Sansh2356/Mice-or-mouse/images/asus_wireless.jpeg

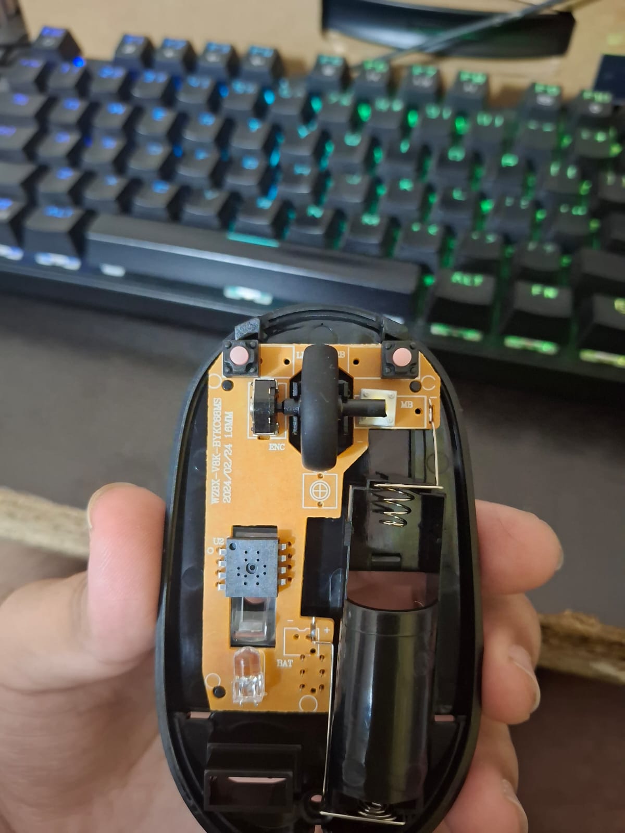
images/asus_wireless.jpeg
