Sansh2356/Mice-or-mouse/images/backview_A603EP.jpeg

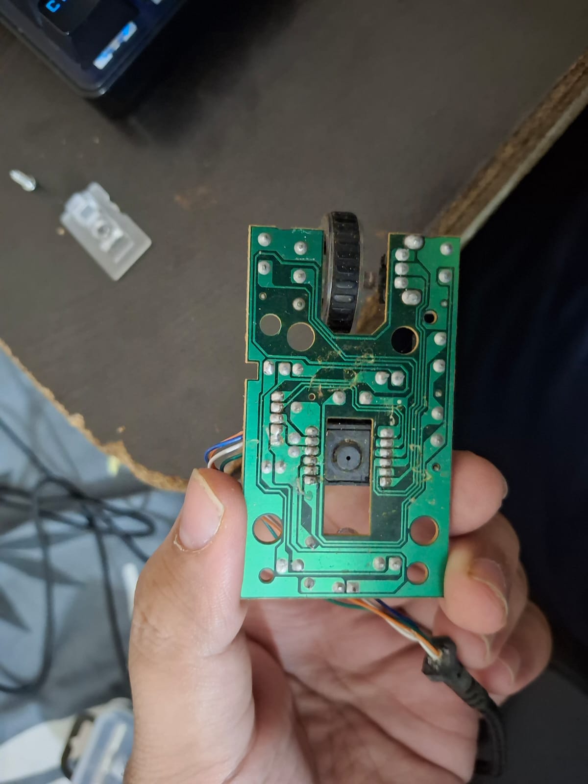
images/backview_A603EP.jpeg
