Sansh2356/Mice-or-mouse/images/closeup_view_front_A603EP.jpeg

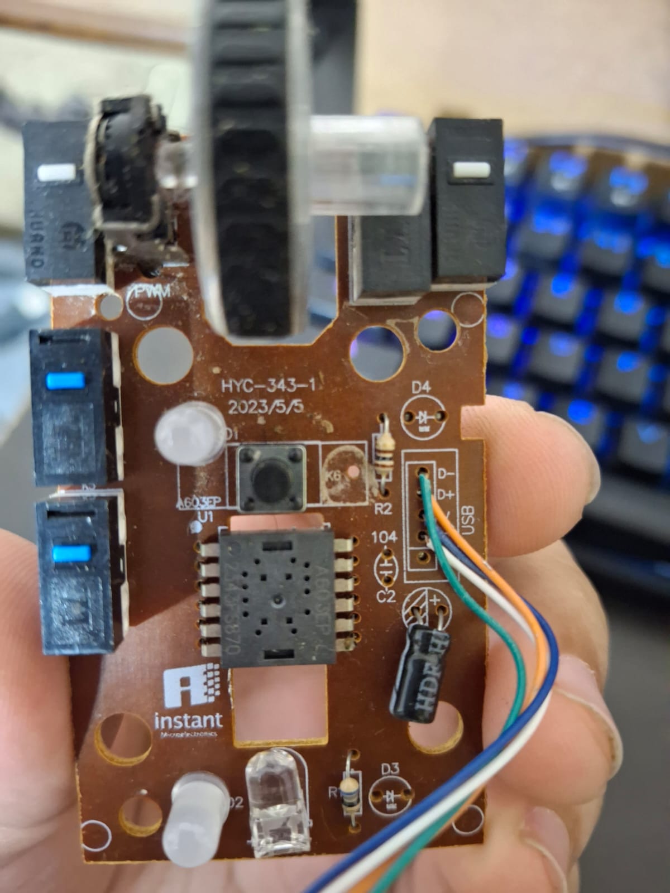
images/closeup_view_front_A603EP.jpeg
