Sansh2356/Mice-or-mouse/images/front_view_A603EP.jpeg

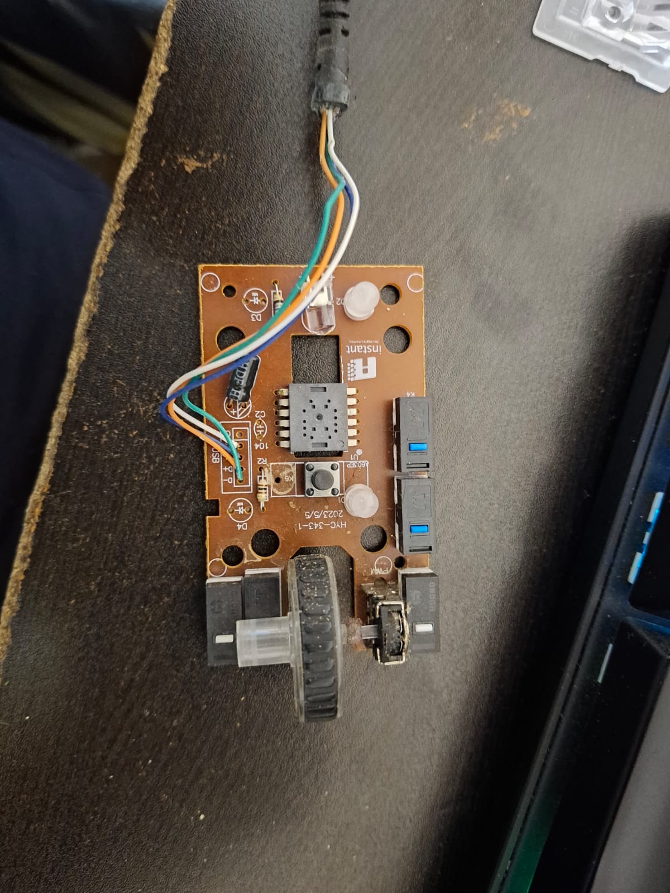
images/front_view_A603EP.jpeg
