Sansh2356/Mice-or-mouse/images/Inner_body_frame.jpeg

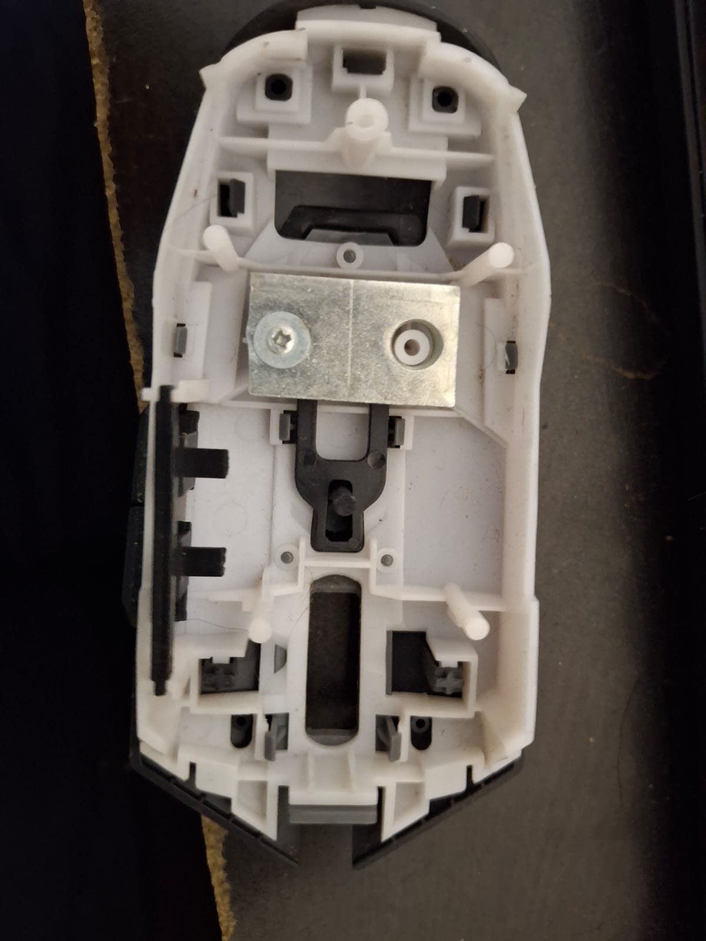
images/Inner_body_frame.jpeg
