Sansh2356/Mice-or-mouse/images/optical_lens_A603EP.jpeg

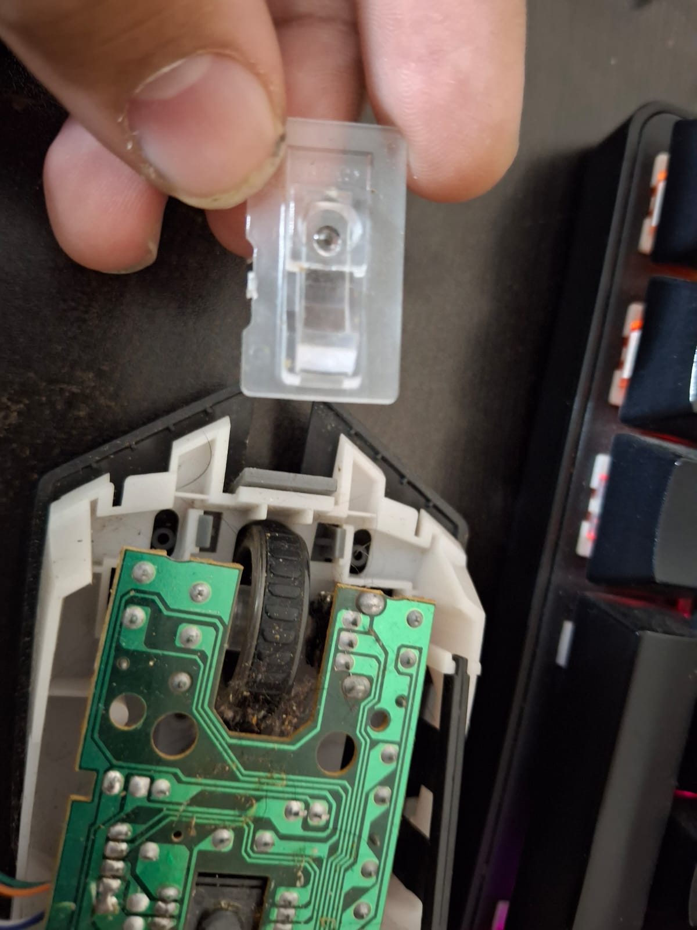
images/optical_lens_A603EP.jpeg
