Sansh2356/Mice-or-mouse/images/Outer_body_frame.jpeg

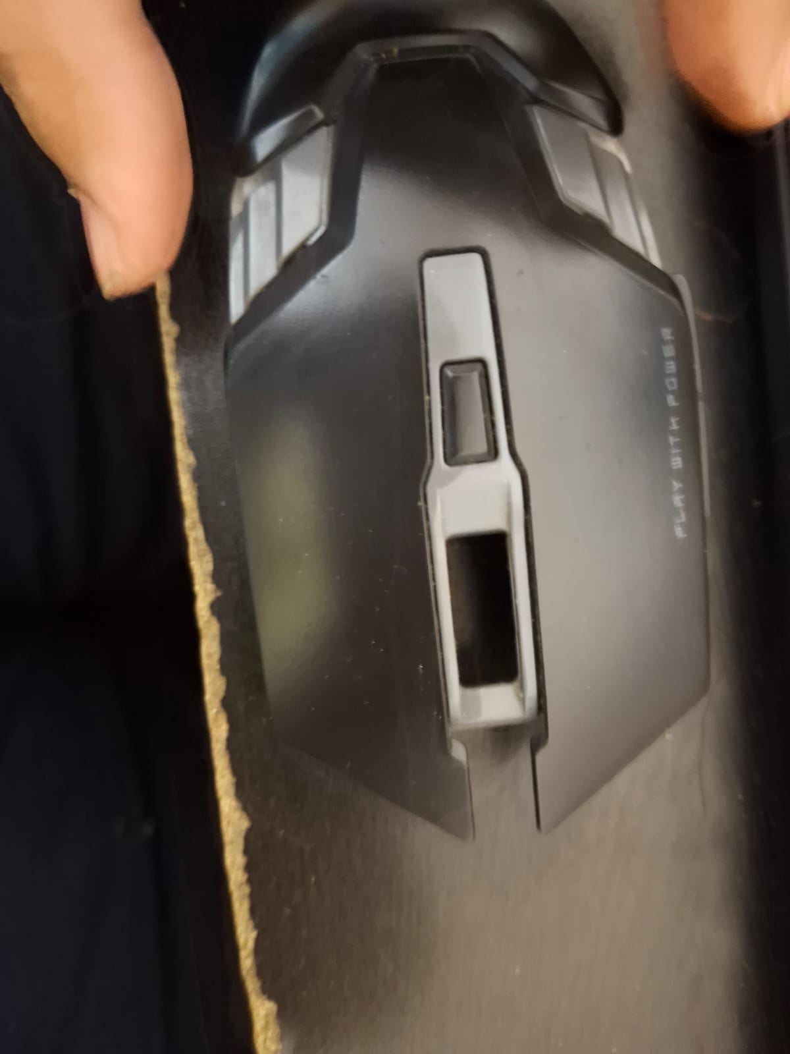
images/Outer_body_frame.jpeg
