Sansh2356/Mice-or-mouse/images/wireless_mouse_1.jpeg

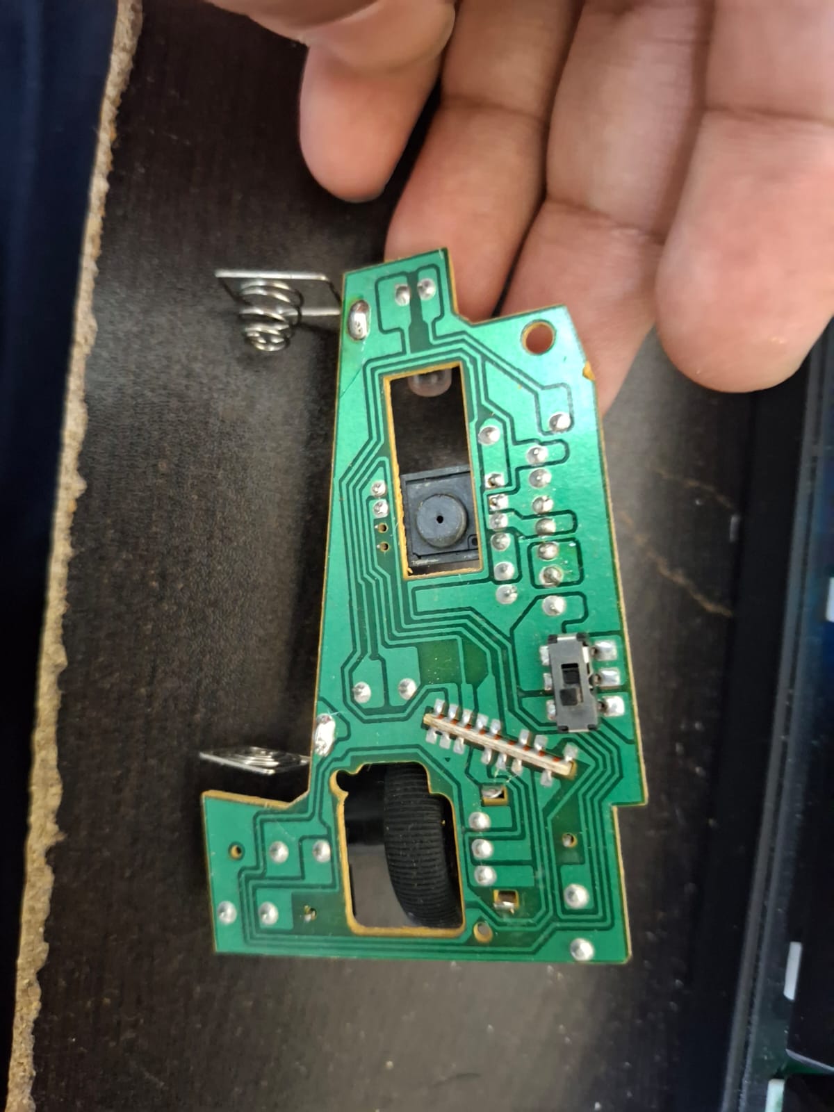
images/wireless_mouse_1.jpeg
