Sansh2356/Mice-or-mouse/images/wireless_mouse_2.jpeg

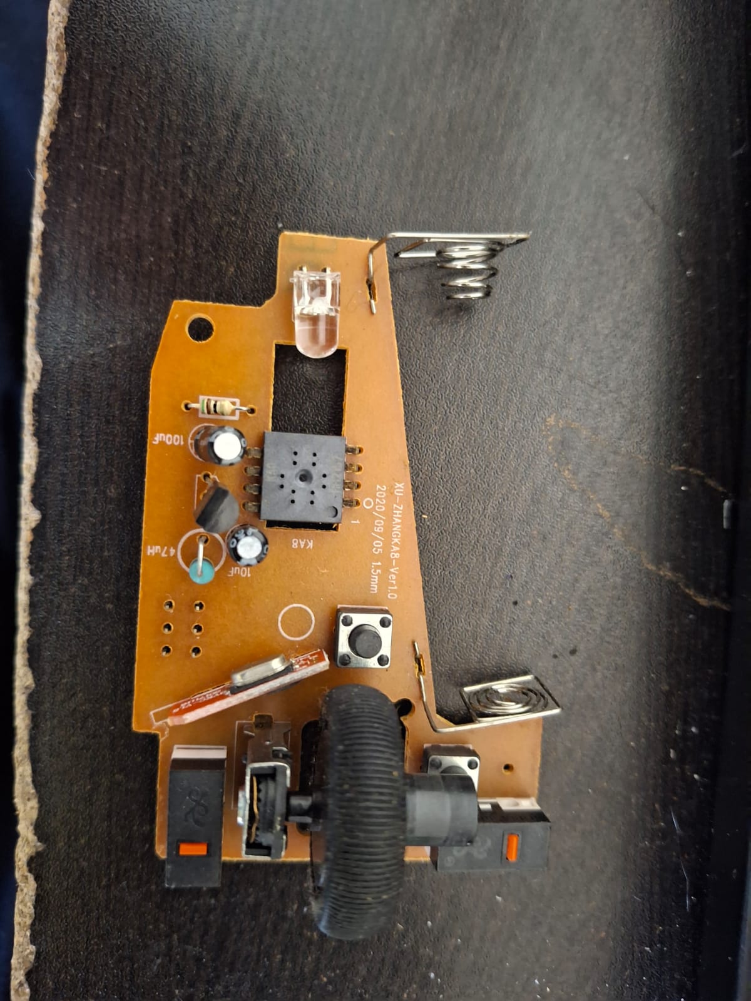
images/wireless_mouse_2.jpeg
