Sansh2356/Mice-or-mouse/kicad/A603EP_traced_circuit.xlsx

Sheet: Pin map
A603EP pin map (traced)
Traced with multimeter on board HYC-343-1 (2023/5/5), 17 Oct 2026. Pin names from A603EP datasheet V1.04.
Pin | Name | Function | Connects to on board | Status
1 | DP | USB D+ | USB D+ pad (orange wire) | Traced
2 | DM | USB D− | USB D− pad (green wire) | Traced
3 | R2 | Button scan input | Right click, DPI button (K6) | Traced
4 | R1 | Button scan input | Middle click, side button 1 | Traced
5 | ZA | Scroll encoder A | Encoder middle leg | Traced
6 | ZB | Scroll encoder B | Encoder outer leg 2 | Traced
7 | R0 | Button scan input | Left click, side button 2 (common leg) | Traced
8 | LED | Tracking LED driver (open drain) | R1 (680 Ω) → tracking LED cathode | Traced
9 | S1 | Button scan output / DPI mode | Side button 1, side button 2 (NO leg), DPI button | Traced
10 | GND | Ground | USB GND (white wire), left/middle/right clicks, C1 −, C2 | Traced
11 | VDD5 | +5V supply | USB +5V (blue wire), C1 +, C2, encoder common, all LED anodes | Traced
12 | bLED | Backlight LED driver | R2 (100 Ω) → D1–D4 cathodes | Traced
Orientation: pin 1 is the leg next to the white dot by the U1 label; pins 1–6 along that row, 7–12 back along the opposite row (pin 12 opposite pin 1).
Note: this mouse uses non-standard USB wire colours; always go by the board labels.

Sheet: Button matrix
Button matrix
Each button connects one scan input (rows) to GND or S1 (columns).
Scan input | GND (pin 10) | S1 (pin 9)
R0 (pin 7) | Left click | Side button 2
R1 (pin 4) | Middle click | Side button 1
R2 (pin 3) | Right click | DPI button (K6)

Sheet: Switches
Switch and encoder wiring
For 3-leg micro-switches, wire common (COM) + normally-open (NO) only; leave normally-closed (NC) unconnected.
Ref | Part | Pin A | Pin B | Notes
SW1 | Left click | Pin 7 (R0) | Pin 10 (GND)
SW2 | Right click | Pin 3 (R2) | Pin 10 (GND)
SW3 | Middle click | Pin 4 (R1) | Pin 10 (GND) | Two of its three legs measured on GND
SW4 | Side button 1 | Pin 4 (R1) | Pin 9 (S1)
SW5 | Side button 2 | COM (middle leg) → pin 7 (R0) | NO (leg 1) → pin 9 (S1) | Leg 3 (NC) also measured on pin 9 on original; leave NC unconnected on new board
SW6 / K6 | DPI tactile button | Pin 3 (R2) | Pin 9 (S1)
ENC1 | Scroll encoder | Common (outer leg 1) → pin 11 (+5V) | A (middle) → pin 5; B (outer leg 2) → pin 6 | Common goes to +5V, NOT GND. Swapping A/B reverses scroll direction

Sheet: Netlist
Netlist
Every net with all its connections — use this to check the KiCad schematic.
Net | Connections
+5V | USB V pad, U1 pin 11, C1 +, C2, ENC1 common, LED1 anode, D1–D4 anodes
GND | USB G pad, U1 pin 10, C1 −, C2, SW1, SW2, SW3
USB_DP | USB D+ pad, U1 pin 1
USB_DM | USB D− pad, U1 pin 2
R0 | U1 pin 7, SW1, SW5 COM
R1 | U1 pin 4, SW3, SW4
R2 | U1 pin 3, SW2, SW6
S1 | U1 pin 9, SW4, SW5 NO, SW6
ZA | U1 pin 5, ENC1 A
ZB | U1 pin 6, ENC1 B
LED_DRV | U1 pin 8, R1 end 1
LED_K | R1 end 2, LED1 cathode
BL_DRV | U1 pin 12, R2 end 1
BL_K | R2 end 2, D1–D4 cathodes

Sheet: BOM
Bill of materials
Values from colour bands and board markings.
Ref | Part | Value | Qty | Notes
U1 | A603EP optical mouse IC | — | 1 | 12-pin; needs custom KiCad symbol and footprint
C1 | Electrolytic capacitor | 47 µF, ≥10V | 1 | Polarised: + to +5V
C2 | Ceramic capacitor | 100 nF (104) | 1 | Empty on original; fit it, close to pins 10/11
R1 | Resistor | 680 Ω | 1 | Blue-grey-brown; tracking LED
R2 | Resistor | 100 Ω | 1 | Brown-black-brown; backlight LEDs
LED1 | Red LED (tracking) | — | 1 | Under the lens; position must match lens light guide
D1, D2 | Backlight LEDs | — | 2 | In parallel, shared R2
D3, D4 | Backlight LEDs | — | 2 | Optional; empty on original, same wiring as D1/D2
SW1–SW5 | Micro-switches | — | 5 | Left, right, middle, side 1, side 2
SW6 | Tactile switch | — | 1 | DPI button (K6)
ENC1 | Mechanical scroll encoder | — | 1 | 3 legs
J1 | USB cable pads | 4 pads | 1 | D+, D−, V, G
— | Optical lens | — | 1 | Reuse original

Sheet: To do
Remaining work
Fill the measurements in mm from one reference corner of the board.
Item | Measurement / value | Done?
Board outline (width × length)
Board thickness
Chip pin pitch
Chip row spacing (left row to right row)
Chip cutout size and position
Tracking LED slot size and position
Lens peg holes (diameter, positions)
Mounting holes (diameter, positions)
Switch positions (SW1–SW6)
Encoder position
USB pad positions
Optional: C1 voltage rating
