Sansh2356/Mice-or-mouse/kicad/A603EP_Mouse_schematic.pdf

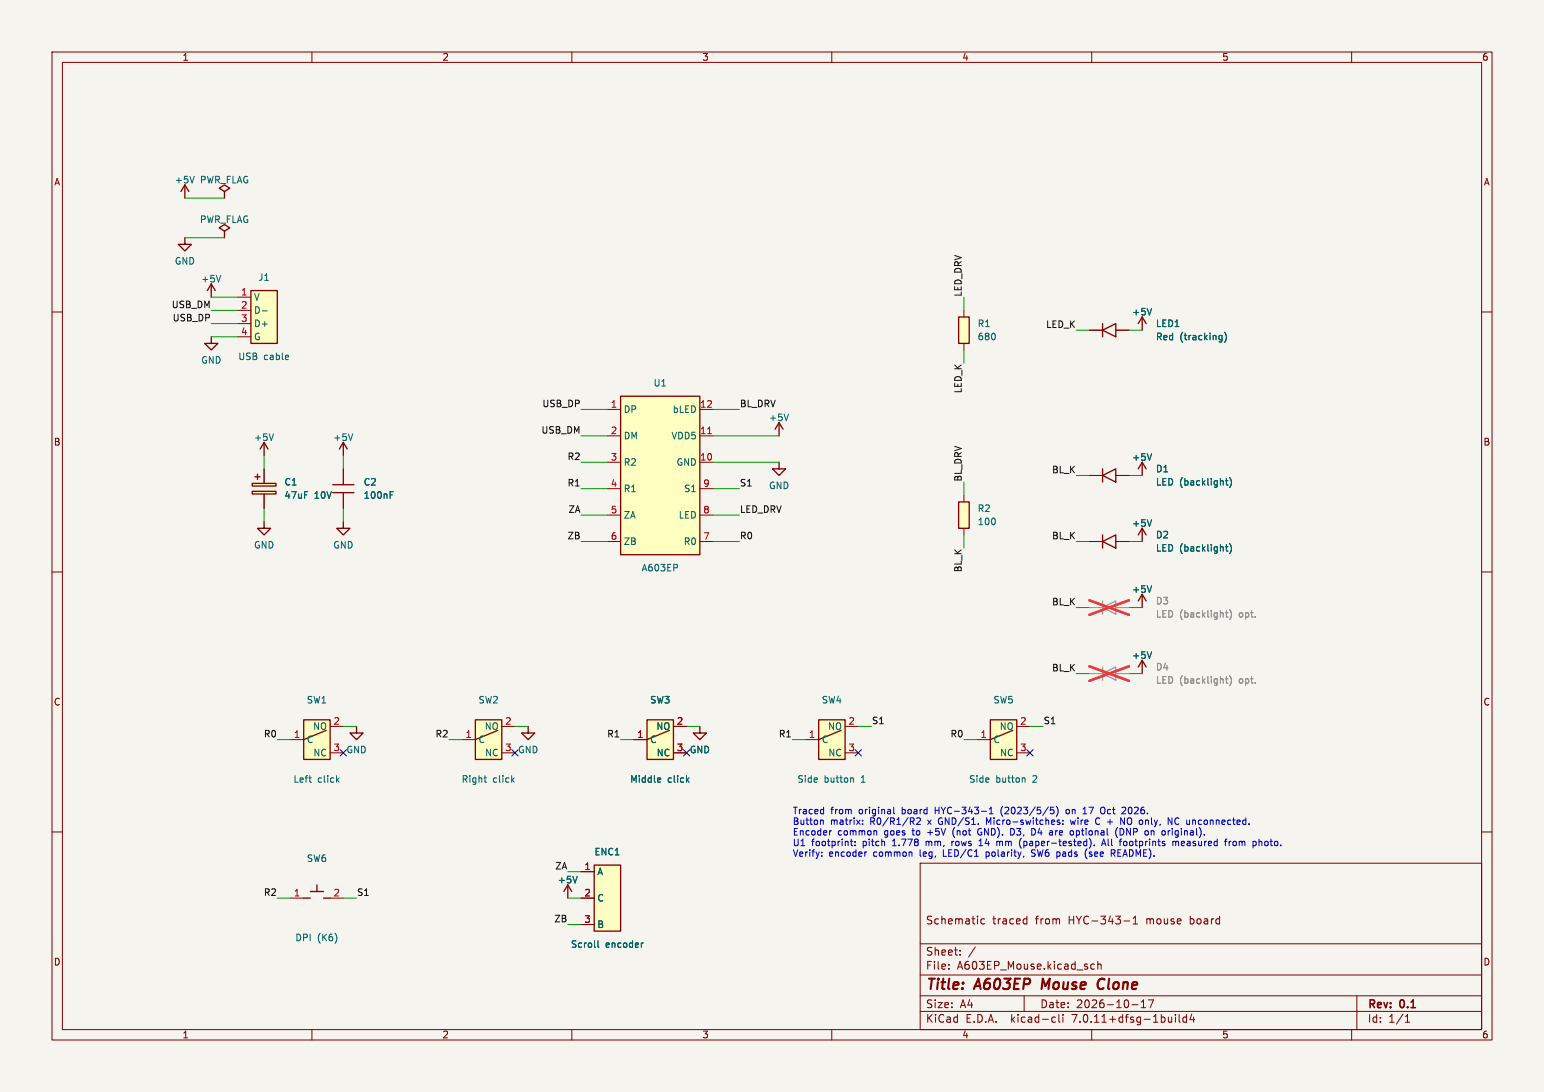
[picture p11: page 1]

Id: 1/1 Title: A603EP Mouse Clone
