Sansh2356/Mice-or-mouse/kicad/A603EP_Mouse.kicad_pcb

## KiCad design kicad/A603EP_Mouse.kicad_pcb (2026-10-19)

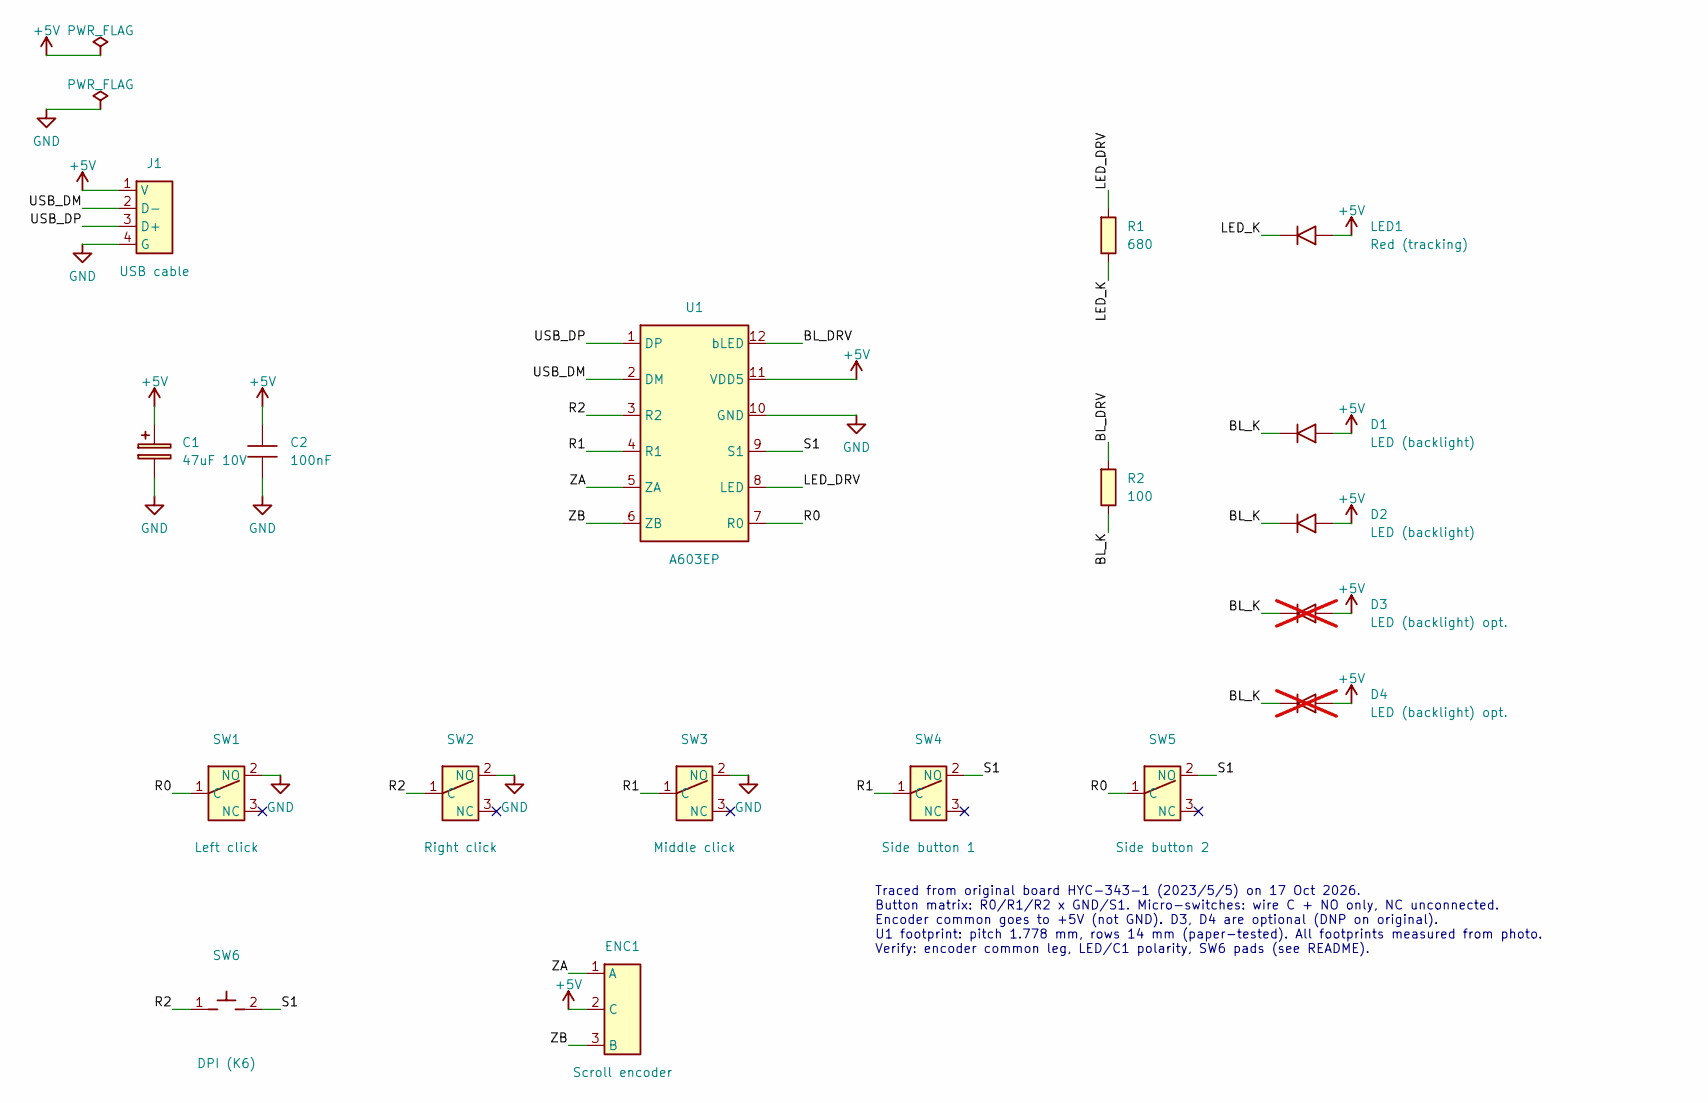
[picture p12: schematic A603EP_Mouse.kicad_sch, A603EP Mouse Clone]

Parts:
C1: 47uF 10V; C1_measured
C2: 100nF; C2_measured
D1: LED (backlight); D1_measured
D2: LED (backlight); D2_measured
D3: LED (backlight) opt.; D3_measured; not fitted
D4: LED (backlight) opt.; D4_measured; not fitted
ENC1: Scroll encoder; ENC1_measured
J1: USB cable; J1_measured
LED1: Red (tracking); LED1_measured
R1: 680; R1_measured
R2: 100; R2_measured
SW1: Left click; SW1_measured
SW2: Right click; SW2_measured
SW3: Middle click; SW3_measured
SW4: Side button 1; SW4_measured
SW5: Side button 2; SW5_measured
SW6: DPI (K6); SW6_measured
U1: A603EP; A603EP_DIP12

Connections:
+5V: C1.1, C2.1, D1.2 (A), D2.2 (A), D3.2 (A), D4.2 (A), ENC1.2 (C), J1.1 (V), LED1.2 (A), U1.11 (VDD5)
BL_DRV: R2.1, U1.12 (bLED)
BL_K: D1.1 (K), D2.1 (K), D3.1 (K), D4.1 (K), R2.2
GND: C1.2, C2.2, J1.4 (G), SW1.2 (NO), SW2.2 (NO), SW3.2 (NO), U1.10 (GND)
LED_DRV: R1.1, U1.8 (LED)
LED_K: LED1.1 (K), R1.2
R0: SW1.1 (C), SW5.1 (C), U1.7 (R0)
R1: SW3.1 (C), SW4.1 (C), U1.4 (R1)
R2: SW2.1 (C), SW6.1, U1.3 (R2)
S1: SW4.2 (NO), SW5.2 (NO), SW6.2, U1.9 (S1)
USB_DM: J1.2 (D-), U1.2 (DM)
USB_DP: J1.3 (D+), U1.1 (DP)
ZA: ENC1.1 (A), U1.5 (ZA)
ZB: ENC1.3 (B), U1.6 (ZB)

Notes on the sheet:
Traced from original board HYC-343-1 (2023/5/5) on 17 Oct 2026. Button matrix: R0/R1/R2 x GND/S1. Micro-switches: wire C + NO only, NC unconnected. Encoder common goes to +5V (not GND). D3, D4 are optional (DNP on original). U1 footprint: pitch 1.778 mm, rows 14 mm (paper-tested). All footprints me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

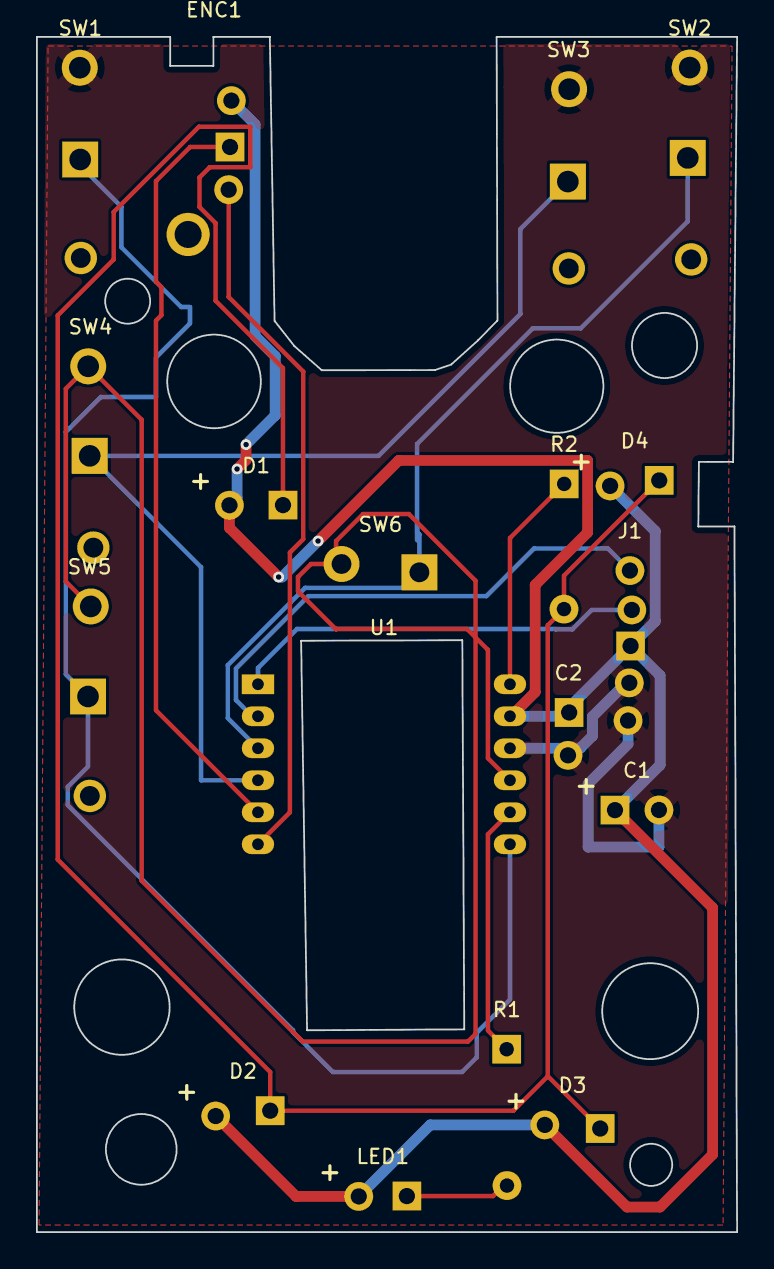
[picture p13: board A603EP_Mouse.kicad_pcb from above]

Board: 2 copper layers, 38.9 x 66.4 mm, 18 parts (0 on the bottom side), 14 nets.
