Sansh2356/Mice-or-mouse/kicad/A603EP_PCB_fit_test.pdf

# A603EP mouse PCB: 1:1 fit test

Print at 100% / "Actual size". The bar must measure exactly 50 mm. Cut out along the outlines.
LEFT: lay on the BROWN (parts) side. RIGHT: lay on the GREEN (solder) side. Check outline, wheel slot, notch, chip window, all 8 holes and every pad. Also try it inside the mouse shell (screw posts, pegs, buttons).
0 | 50 mm
Brown (component) side | Green (solder) side, mirrored

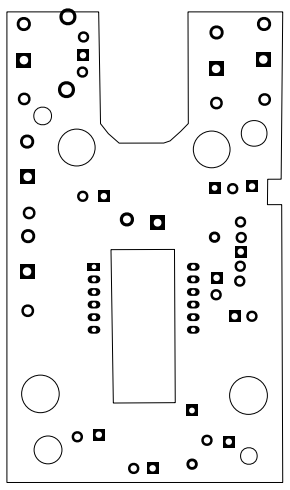
[picture p14: figure]
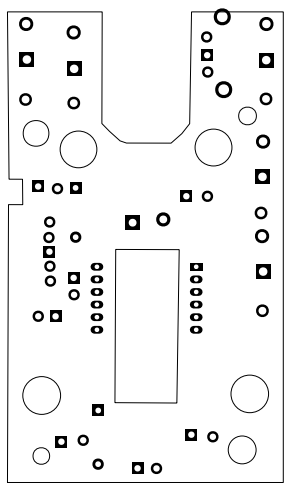
[picture p15: figure]

Board 38.9 x 66.4 mm (calibrated from the chip pads; your ruler gave 40 x 65). Positions measured from photo, about +-0.3 mm.
