Sansh2356/Mice-or-mouse/(commit log)

2026-10-18 chore: adding sampled images for internal understanding of pcbs of both wireless dual chip and wired single chip mouses
2026-10-18 feat: adding initial schematic,symbol and pcb diagrams respectively first iteration and a test measurement estimate along with tracing generated via continuity estimations and circuit tracing
    [A603EP_Mouse.kicad_pcb, A603EP_Mouse.kicad_sch, A603EP_traced_circuit.xlsx]
2026-10-19 chore: removing gerbers from ignorefiles
2026-10-19 fix: updating pcb and pretty files wrt to notch for mouse encoder identified during path tracing and design error checker
    [A603EP_Mouse.kicad_pcb, A603EP_Mouse_before_notch.kicad_pcb]
2026-10-19 chore: auto-generated gerber files via kicad for the corresponding V1 pcb deisgn reversed
    [A603EP_Mouse-B_Cu.gbl, A603EP_Mouse-B_Mask.gbs, A603EP_Mouse-B_Paste.gbp, A603EP_Mouse-B_Silkscreen.gbo, A603EP_Mouse-Edge_Cuts.gm1, A603EP_Mouse-F_Cu.gtl, A603EP_Mouse-F_Mask.gts, A603EP_Mouse-F_Paste.gtp]
2026-10-19 chore: adding breif readme and pcb png
